6mil-Labs/remake/cad/components/R_0402_1005Metric.step

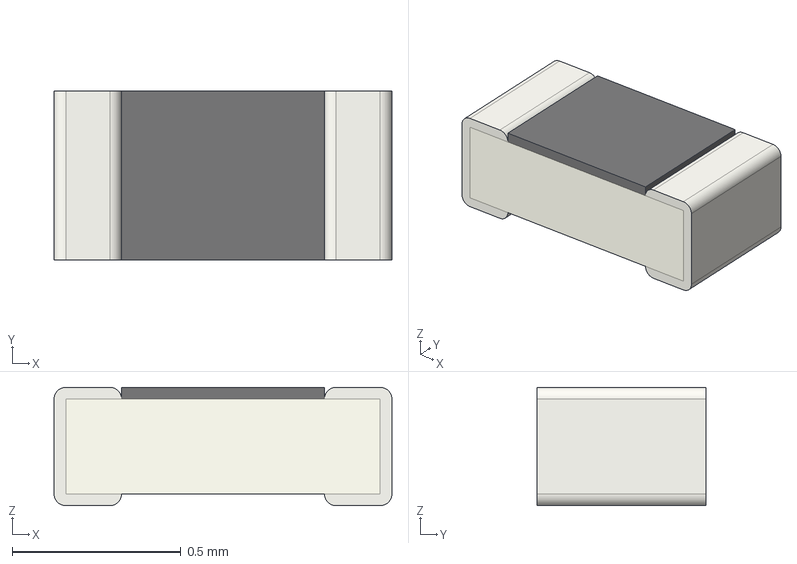
[picture p1: CAD file, 2026-11-06]
cad/components/R_0402_1005Metric.step
1.00 x 0.5 x 0.35 mm
