6mil-Labs/remake/cad/components/SW_Hotswap_Kailh_Choc_V1.step

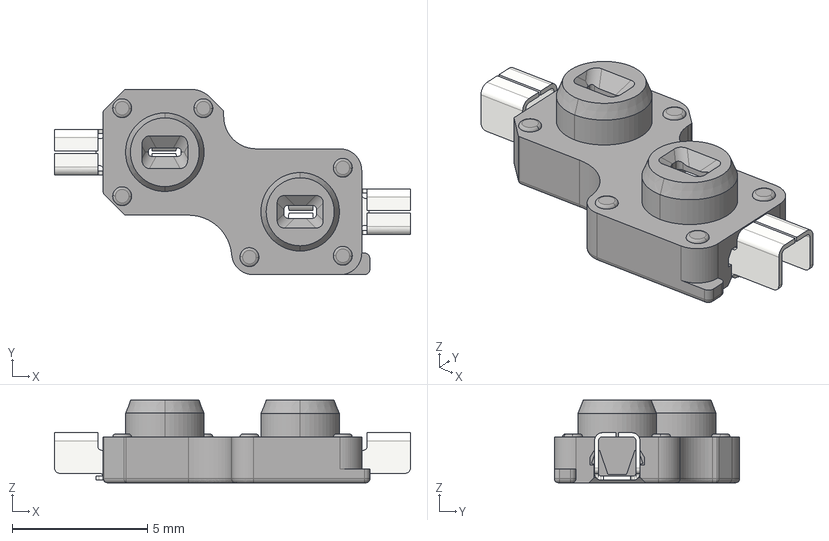
[picture p2: CAD file, 2026-10-26]
cad/components/SW_Hotswap_Kailh_Choc_V1.step
13.2 x 6.85 x 3.05 mm
