6mil-Labs/remake/cad/components/D_SOD123.step

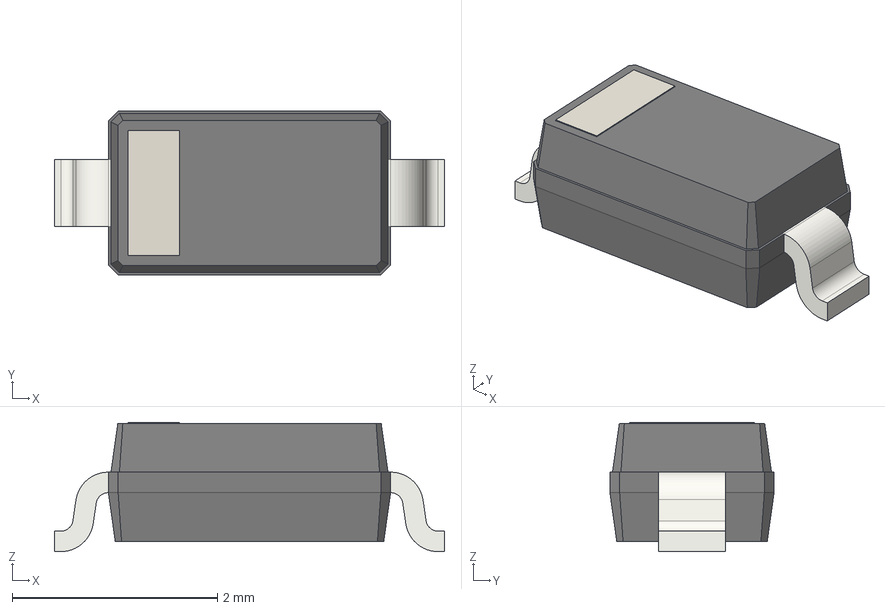
[picture p3: CAD file, 2026-10-26]
cad/components/D_SOD123.step
3.80 x 1.60 x 1.26 mm
