6mil-Labs/remake/cad/components/SW_Kailh_Choc_V1.step

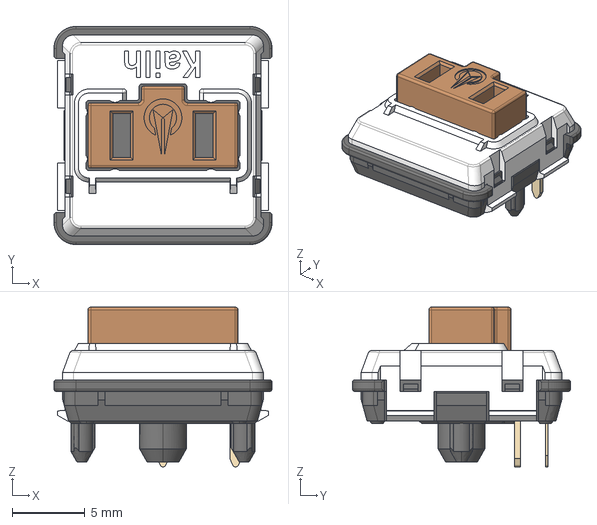
[picture p4: CAD file, 2026-10-26]
cad/components/SW_Kailh_Choc_V1.step
15.0 x 15.0 x 11.0 mm
