6mil-Labs/remake/cad/components/Panasonic_EVQPUJ_EVQPUA.step

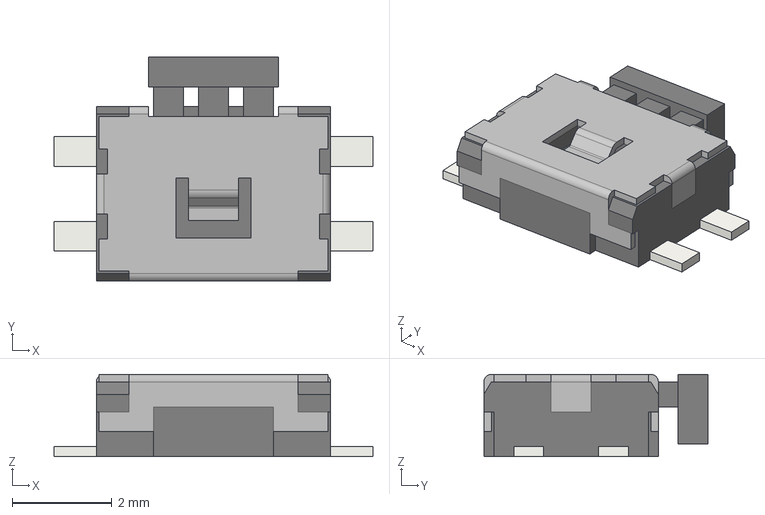
[picture p5: CAD file, 2026-10-26]
cad/components/Panasonic_EVQPUJ_EVQPUA.step
6.40 x 4.50 x 1.65 mm
