6mil-Labs/remake/cad/components/SW_MSK12C02.step

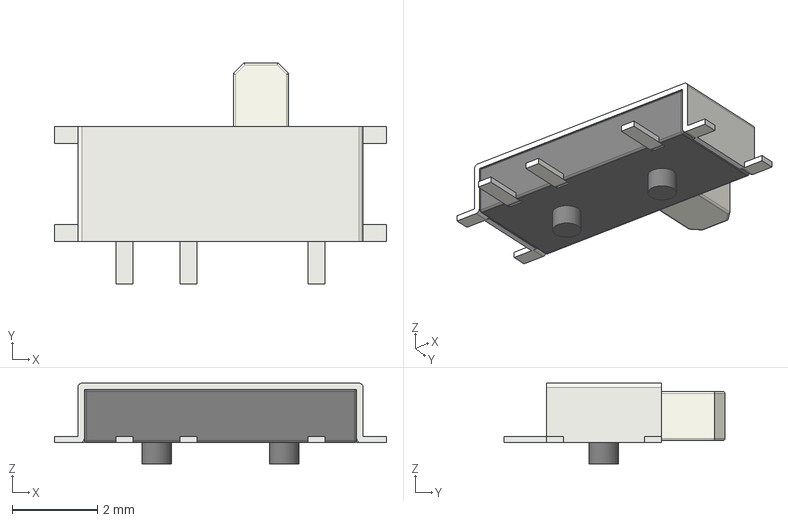
[picture p6: CAD file, 2026-10-26]
cad/components/SW_MSK12C02.step
7.80 x 5.20 x 1.90 mm
