6mil-Labs/remake/hw/remake.kicad_pcb

## KiCad design hw/remake.kicad_pcb (2026-11-13)

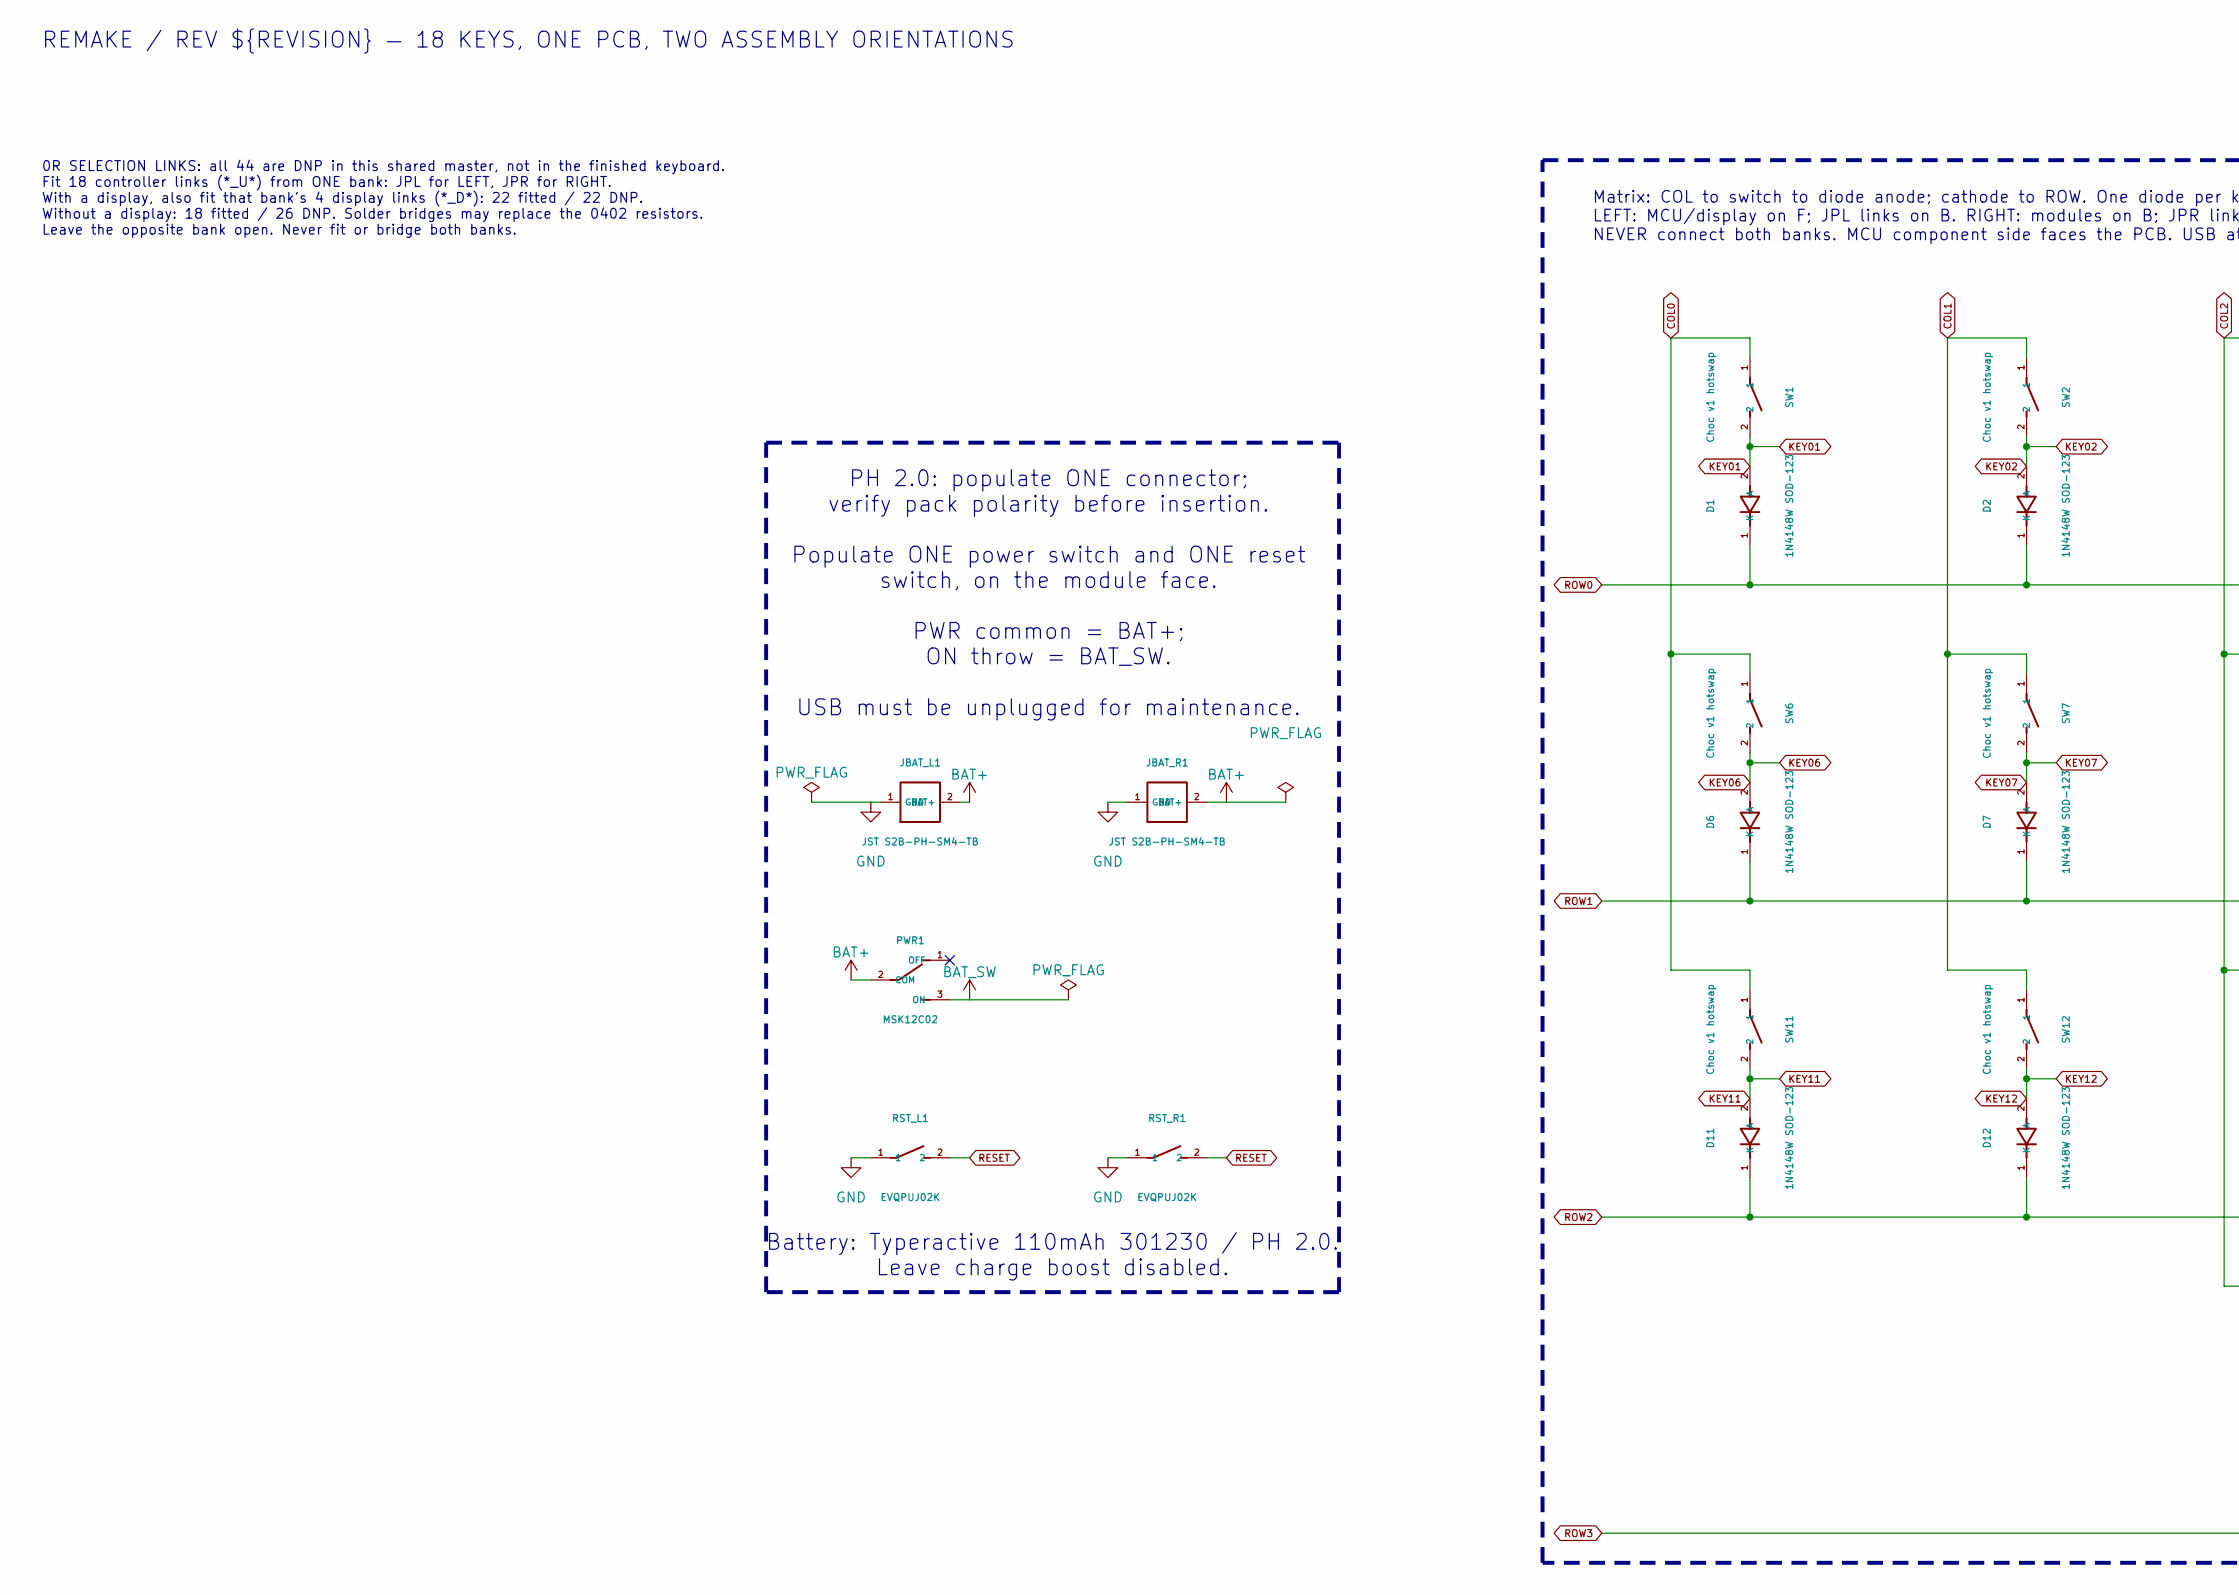
[picture p7: schematic remake.kicad_sch, part in row 1, column 1]

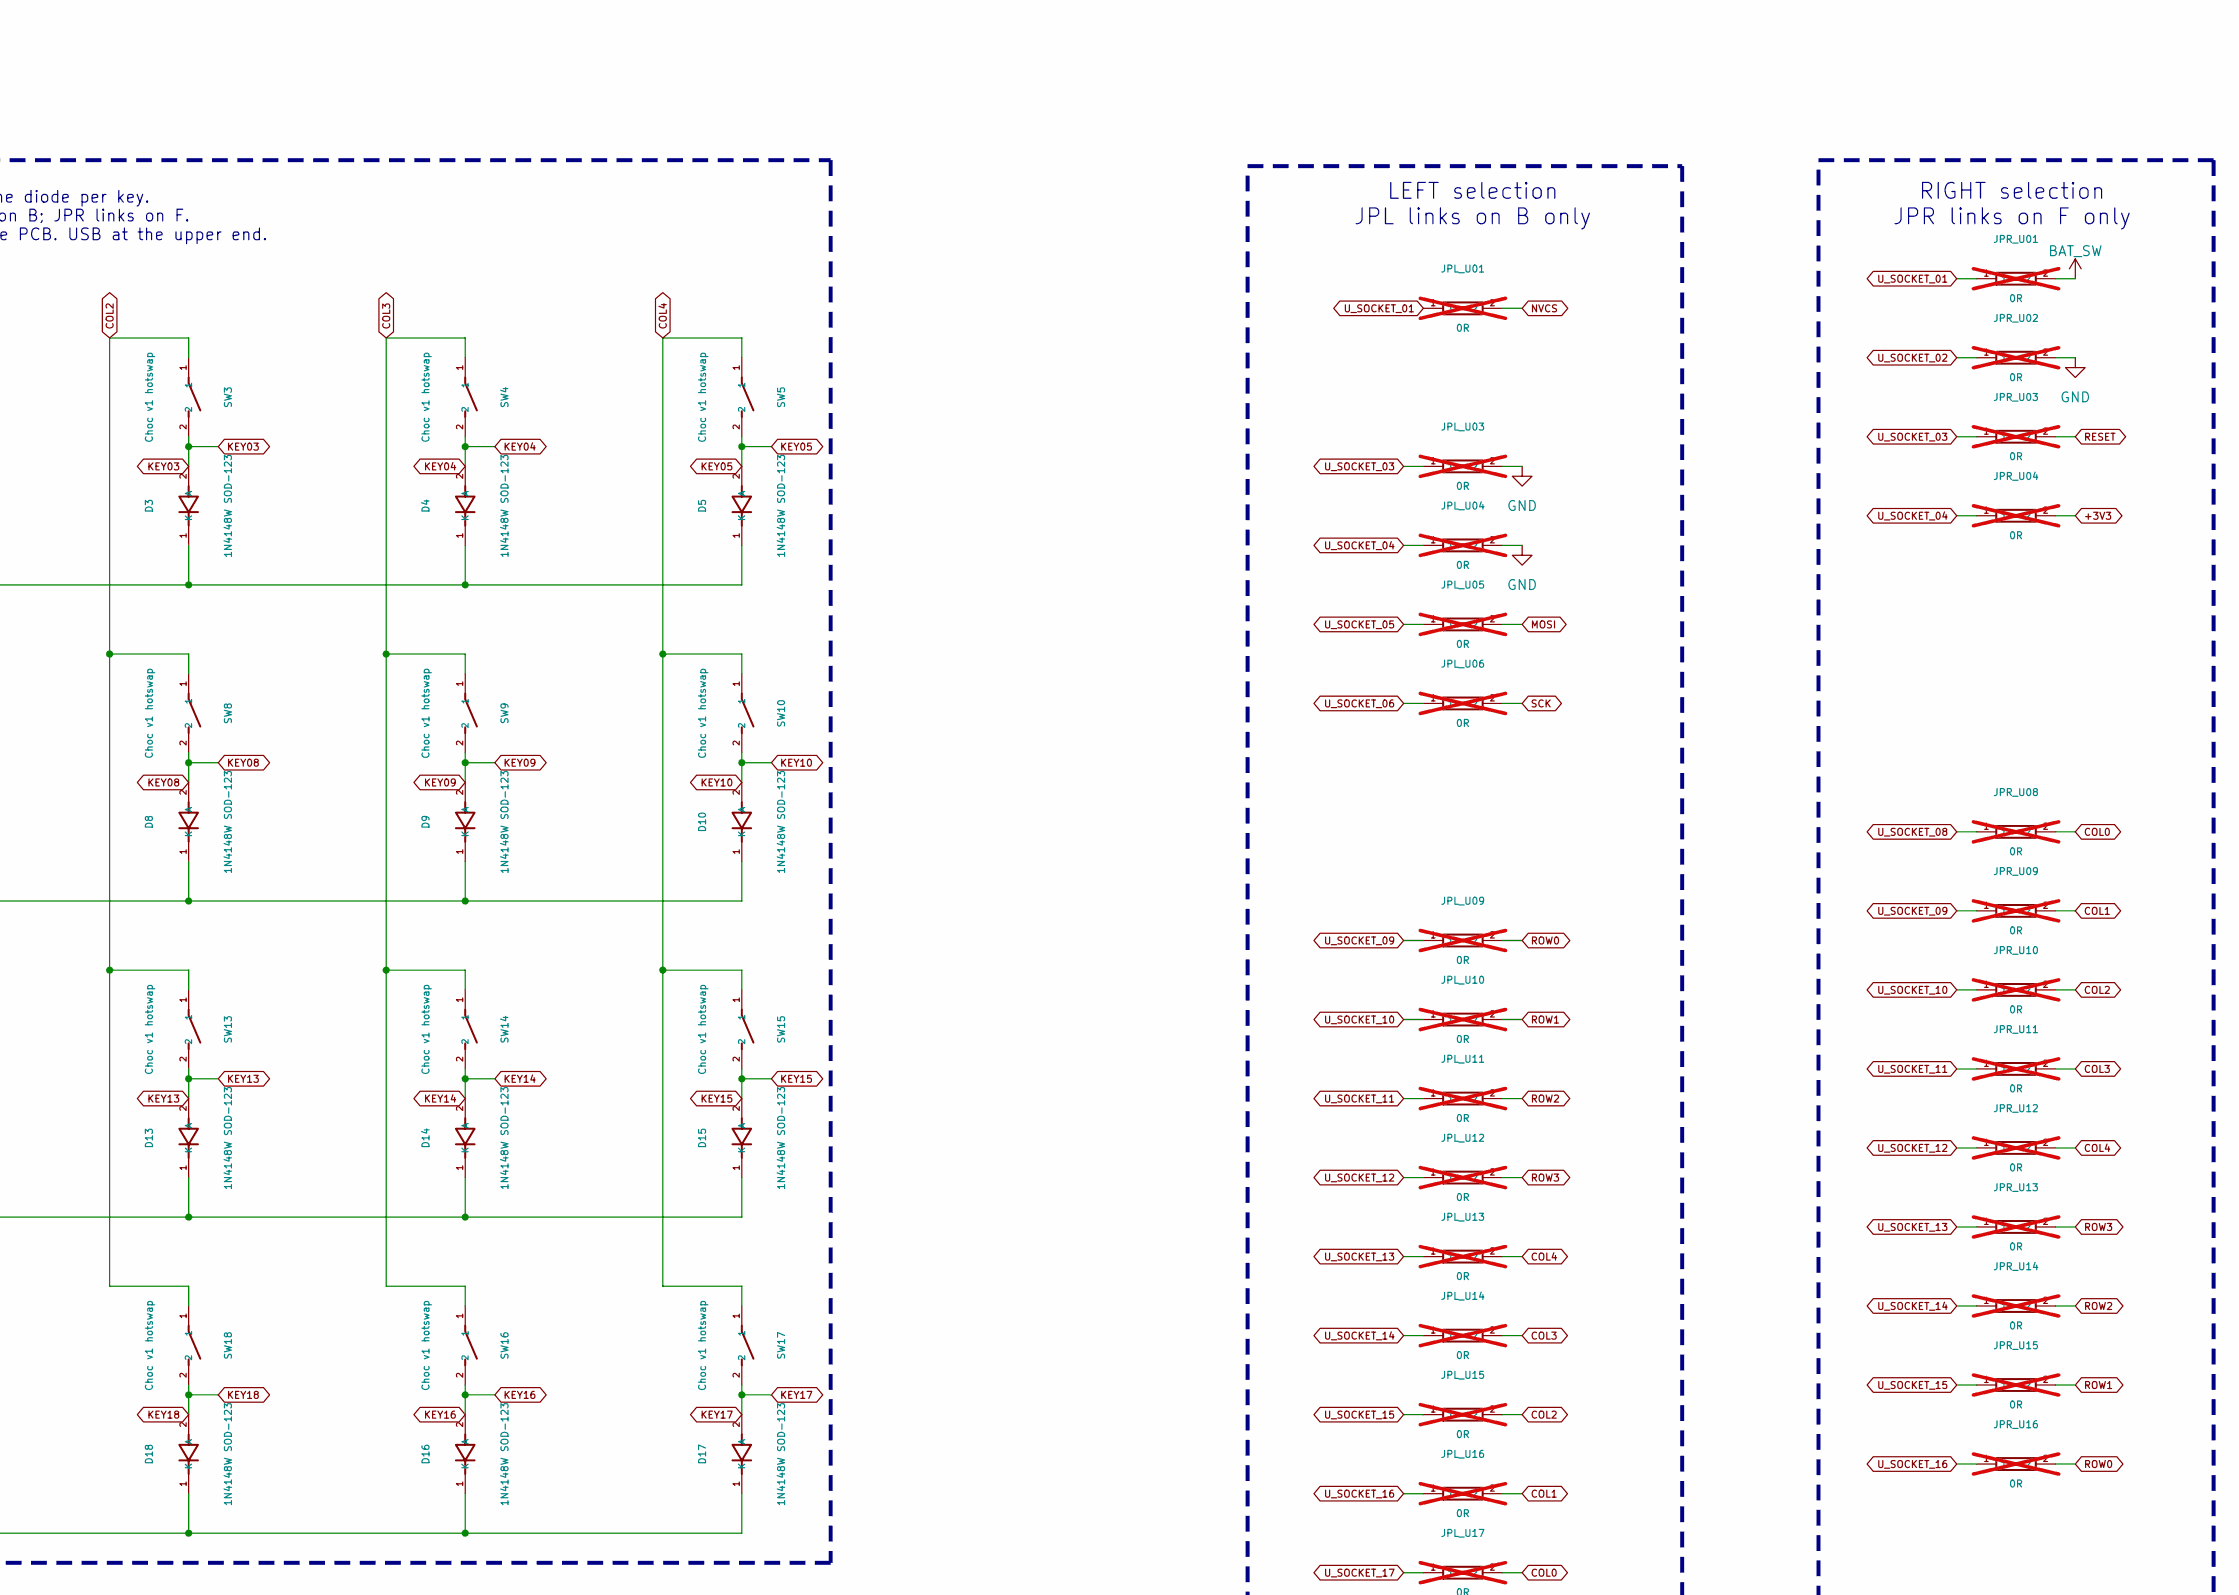
[picture p8: schematic remake.kicad_sch, part in row 1, column 2]

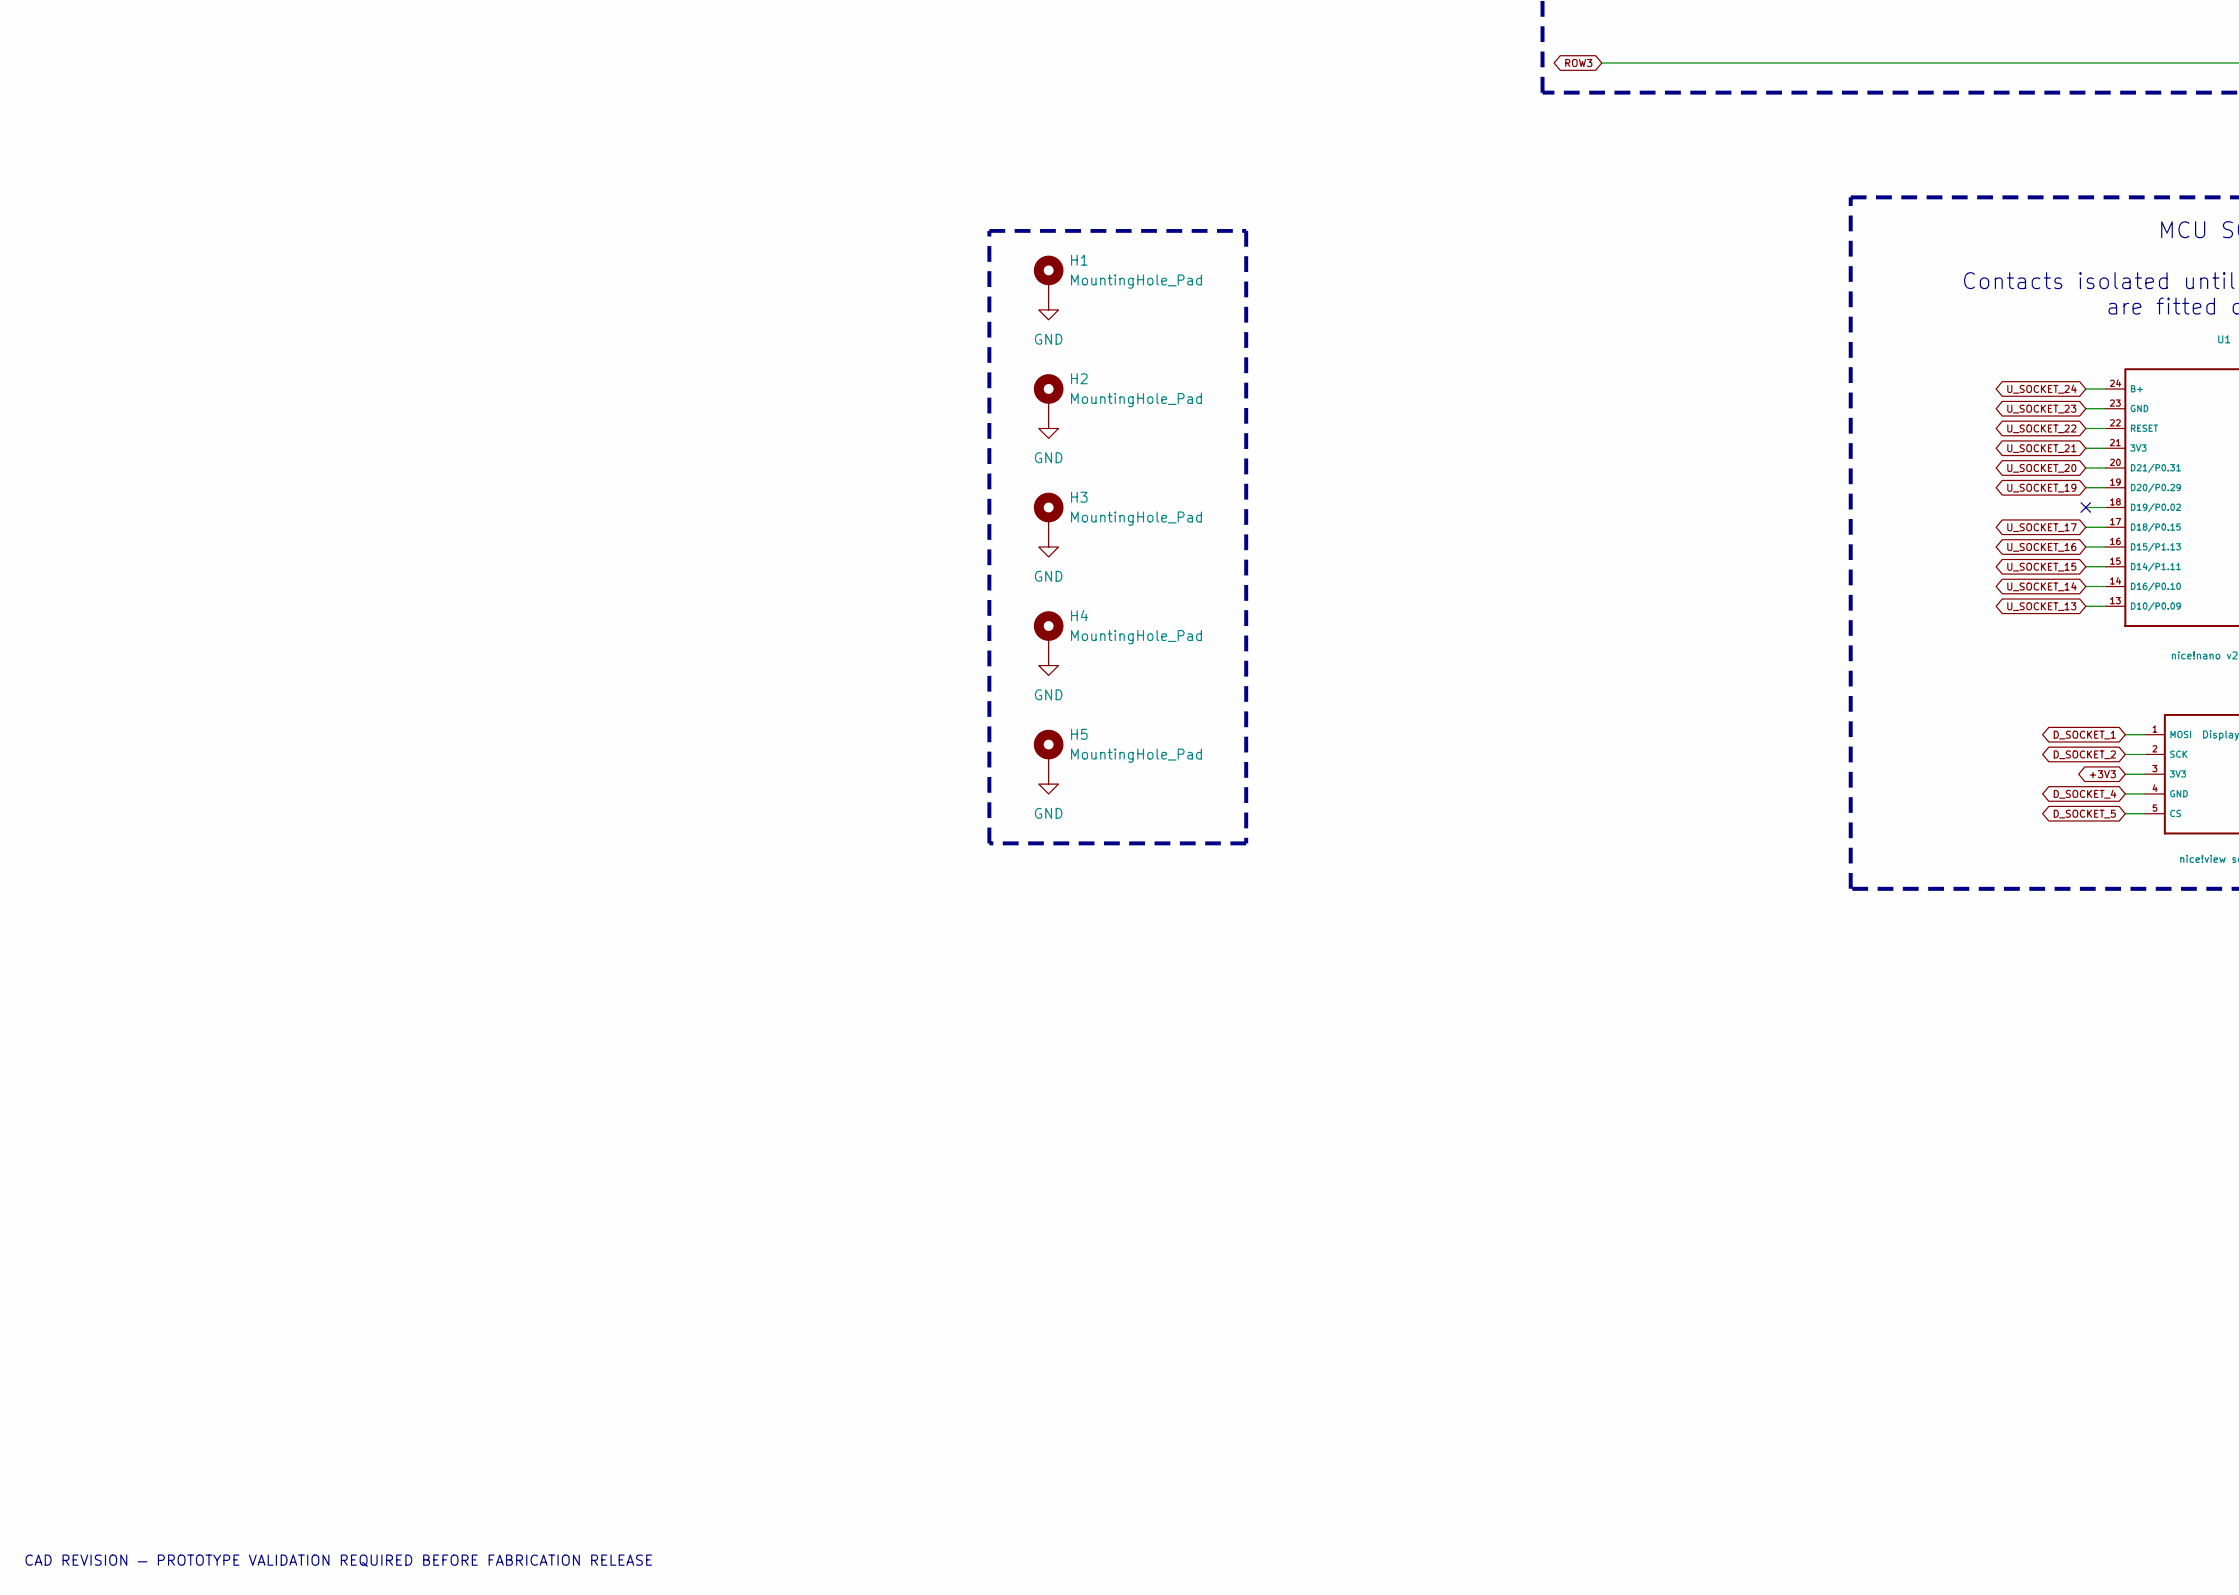
[picture p9: schematic remake.kicad_sch, part in row 2, column 1]

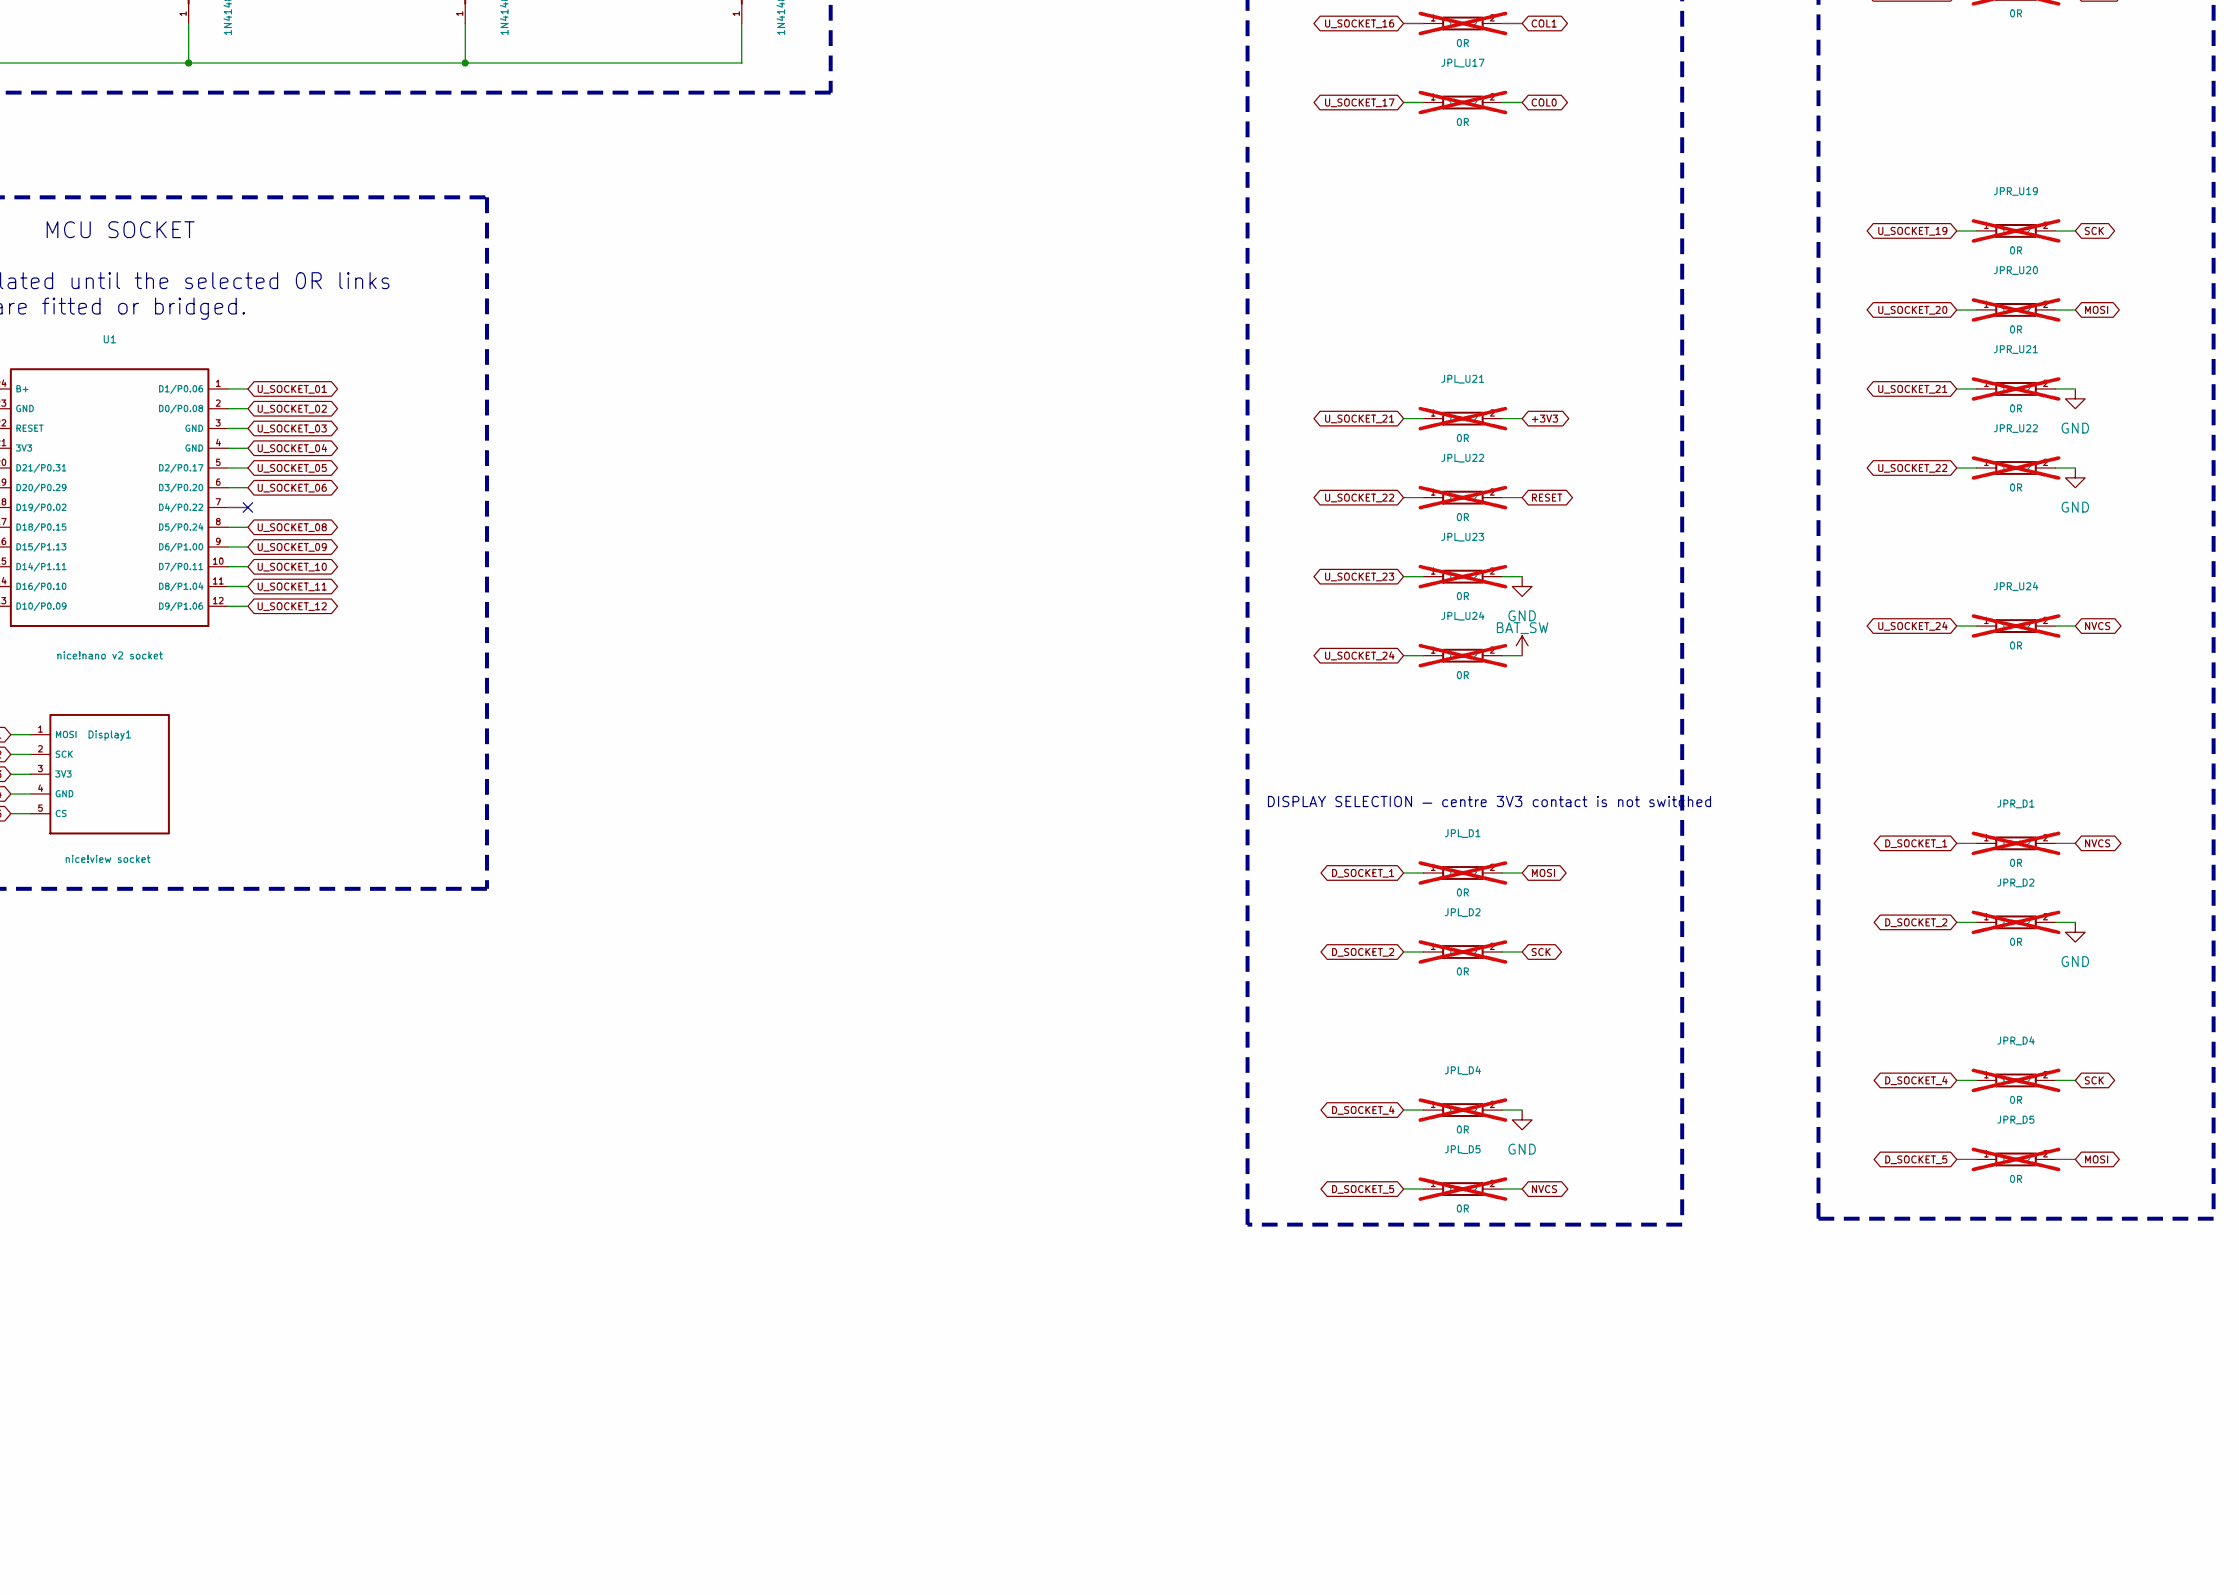
[picture p10: schematic remake.kicad_sch, part in row 2, column 2]

Parts:
D1, D2, D3, D4, D5, D6, D7, D8, D9, D10, D11, D12, D13, D14, D15, D16, D17, D18: 1N4148W SOD-123; Diode_SOD123_reversible
Display1: nice!view socket; nice_view_reversible
H1, H2, H3, H4, H5: MountingHole_Pad; MountingHole_2.2mm_M2_ISO7380_Pad_TopBottom
JBAT_L1: JST S2B-PH-SM4-TB; JST_PH_2mm_side_entry
JBAT_R1: JST S2B-PH-SM4-TB; JST_PH_2mm_side_entry
JPL_D1, JPL_D2, JPL_D4, JPL_D5: 0R; R_0402_1005Metric_SolderJumper; not fitted
JPL_U01, JPL_U03, JPL_U04, JPL_U05, JPL_U06, JPL_U09, JPL_U10, JPL_U11, JPL_U12, JPL_U13, JPL_U14, JPL_U15, JPL_U16, JPL_U17, JPL_U21, JPL_U22, JPL_U23, JPL_U24: 0R; R_0402_1005Metric_SolderJumper; not fitted
JPR_D1, JPR_D2, JPR_D4, JPR_D5: 0R; R_0402_1005Metric_SolderJumper; not fitted
JPR_U01, JPR_U02, JPR_U03, JPR_U04, JPR_U08, JPR_U09, JPR_U10, JPR_U11, JPR_U12, JPR_U13, JPR_U14, JPR_U15, JPR_U16, JPR_U19, JPR_U20, JPR_U21, JPR_U22, JPR_U24: 0R; R_0402_1005Metric_SolderJumper; not fitted
PWR1: MSK12C02; SW_Power_MSK12C02_reversible
RST_L1: EVQPUJ02K; SW_SPST_Panasonic_EVQPUJ02K
RST_R1: EVQPUJ02K; SW_SPST_Panasonic_EVQPUJ02K
SW1, SW2, SW3, SW4, SW5, SW6, SW7, SW8, SW9, SW10, SW11, SW12, SW13, SW14, SW15, SW16, SW17, SW18: Choc v1 hotswap; SW_Hotswap_Kailh_Choc_V1_reversible
U1: nice!nano v2 socket; nice_nano_reversible

Connections:
+3V3: Display1.3 (3V3), JPL_U21.2, JPR_U04.2
BAT+: JBAT_L1.2 (BAT+), JBAT_R1.2 (BAT+), PWR1.2 (COM)
BAT_SW: JPL_U24.2, JPR_U01.2, PWR1.3 (ON)
COL0: JPL_U17.2, JPR_U08.2, SW1.1, SW6.1, SW11.1
COL1: JPL_U16.2, JPR_U09.2, SW2.1, SW7.1, SW12.1
COL2: JPL_U15.2, JPR_U10.2, SW3.1, SW8.1, SW13.1, SW18.1
COL3: JPL_U14.2, JPR_U11.2, SW4.1, SW9.1, SW14.1, SW16.1
COL4: JPL_U13.2, JPR_U12.2, SW5.1, SW10.1, SW15.1, SW17.1
D_SOCKET_1: Display1.1 (MOSI), JPL_D1.1, JPR_D1.1
D_SOCKET_2: Display1.2 (SCK), JPL_D2.1, JPR_D2.1
D_SOCKET_4: Display1.4 (GND), JPL_D4.1, JPR_D4.1
D_SOCKET_5: Display1.5 (CS), JPL_D5.1, JPR_D5.1
GND: H1.1 (1_1), H2.1 (1_1), H3.1 (1_1), H4.1 (1_1), H5.1 (1_1), JBAT_L1.1 (GND), JBAT_R1.1 (GND), JPL_D4.2, JPL_U03.2, JPL_U04.2, JPL_U23.2, JPR_D2.2, JPR_U02.2, JPR_U21.2, JPR_U22.2, RST_L1.1, RST_R1.1
KEY01: D1.2 (A), SW1.2
KEY02: D2.2 (A), SW2.2
KEY03: D3.2 (A), SW3.2
KEY04: D4.2 (A), SW4.2
KEY05: D5.2 (A), SW5.2
KEY06: D6.2 (A), SW6.2
KEY07: D7.2 (A), SW7.2
KEY08: D8.2 (A), SW8.2
KEY09: D9.2 (A), SW9.2
KEY10: D10.2 (A), SW10.2
KEY11: D11.2 (A), SW11.2
KEY12: D12.2 (A), SW12.2
KEY13: D13.2 (A), SW13.2
KEY14: D14.2 (A), SW14.2
KEY15: D15.2 (A), SW15.2
KEY16: D16.2 (A), SW16.2
KEY17: D17.2 (A), SW17.2
KEY18: D18.2 (A), SW18.2
MOSI: JPL_D1.2, JPL_U05.2, JPR_D5.2, JPR_U20.2
NVCS: JPL_D5.2, JPL_U01.2, JPR_D1.2, JPR_U24.2
RESET: JPL_U22.2, JPR_U03.2, RST_L1.2, RST_R1.2
ROW0: D1.1 (K), D2.1 (K), D3.1 (K), D4.1 (K), D5.1 (K), JPL_U09.2, JPR_U16.2
ROW1: D6.1 (K), D7.1 (K), D8.1 (K), D9.1 (K), D10.1 (K), JPL_U10.2, JPR_U15.2
ROW2: D11.1 (K), D12.1 (K), D13.1 (K), D14.1 (K), D15.1 (K), JPL_U11.2, JPR_U14.2
ROW3: D16.1 (K), D17.1 (K), D18.1 (K), JPL_U12.2, JPR_U13.2
SCK: JPL_D2.2, JPL_U06.2, JPR_D4.2, JPR_U19.2
U_SOCKET_01: JPL_U01.1, JPR_U01.1, U1.1 (D1/P0.06)
U_SOCKET_02: JPR_U02.1, U1.2 (D0/P0.08)
U_SOCKET_03: JPL_U03.1, JPR_U03.1, U1.3 (GND)
U_SOCKET_04: JPL_U04.1, JPR_U04.1, U1.4 (GND)
U_SOCKET_05: JPL_U05.1, U1.5 (D2/P0.17)
U_SOCKET_06: JPL_U06.1, U1.6 (D3/P0.20)
U_SOCKET_08: JPR_U08.1, U1.8 (D5/P0.24)
U_SOCKET_09: JPL_U09.1, JPR_U09.1, U1.9 (D6/P1.00)
U_SOCKET_10: JPL_U10.1, JPR_U10.1, U1.10 (D7/P0.11)
U_SOCKET_11: JPL_U11.1, JPR_U11.1, U1.11 (D8/P1.04)
U_SOCKET_12: JPL_U12.1, JPR_U12.1, U1.12 (D9/P1.06)
U_SOCKET_13: JPL_U13.1, JPR_U13.1, U1.13 (D10/P0.09)
U_SOCKET_14: JPL_U14.1, JPR_U14.1, U1.14 (D16/P0.10)
U_SOCKET_15: JPL_U15.1, JPR_U15.1, U1.15 (D14/P1.11)
U_SOCKET_16: JPL_U16.1, JPR_U16.1, U1.16 (D15/P1.13)
U_SOCKET_17: JPL_U17.1, U1.17 (D18/P0.15)
U_SOCKET_19: JPR_U19.1, U1.19 (D20/P0.29)
U_SOCKET_20: JPR_U20.1, U1.20 (D21/P0.31)
U_SOCKET_21: JPL_U21.1, JPR_U21.1, U1.21 (3V3)
U_SOCKET_22: JPL_U22.1, JPR_U22.1, U1.22 (RESET)
U_SOCKET_23: JPL_U23.1, U1.23 (GND)
U_SOCKET_24: JPL_U24.1, JPR_U24.1, U1.24 (B+)

Notes on the sheet:
DISPLAY SELECTION — centre 3V3 contact is not switched
CAD REVISION — PROTOTYPE VALIDATION REQUIRED BEFORE FABRICATION RELEASE
REMAKE / REV ${REVISION} — 18 KEYS, ONE PCB, TWO ASSEMBLY ORIENTATIONS
LEFT selection JPL links on B only
PH 2.0: populate ONE connector; verify pack polarity before insertion. Populate ONE power switch and ONE reset switch, on the module face. PWR common = BAT+; ON throw = BAT_SW. USB must be unplugged for maintenance.
MCU SOCKET Contacts isolated until the selected 0R links are fitted or bridged.
Matrix: COL to switch to diode anode; cathode to ROW. One diode per key. LEFT: MCU/display on F; JPL links on B. RIGHT: modules on B; JPR links on F. NEVER connect both banks. MCU component side faces the PCB. USB at the upper end.
Battery: Typeractive 110mAh 301230 / PH 2.0. Leave charge boost disabled.
RIGHT selection JPR links on F only
0R SELECTION LINKS: all 44 are DNP in this shared master, not in the finished keyboard. Fit 18 controller links (*_U*) from ONE bank: JPL for LEFT, JPR for RIGHT. With a display, also fit that bank's 4 display links (*_D*): 22 fitted / 22 DNP. Without a display: 18 fitted / 26 DNP. Solder bridges m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

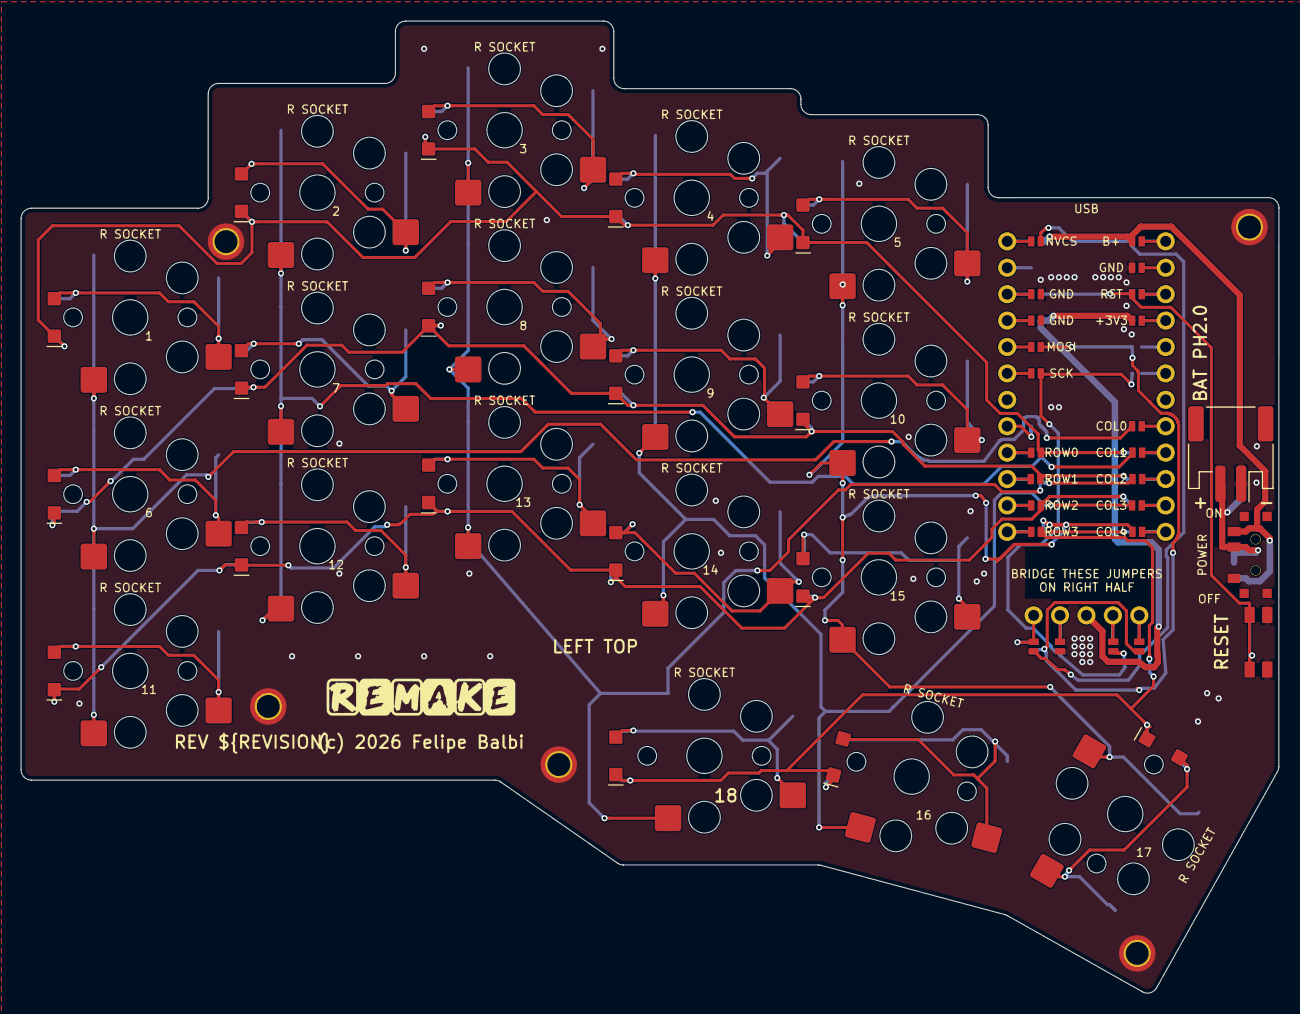
[picture p11: board remake.kicad_pcb from above]

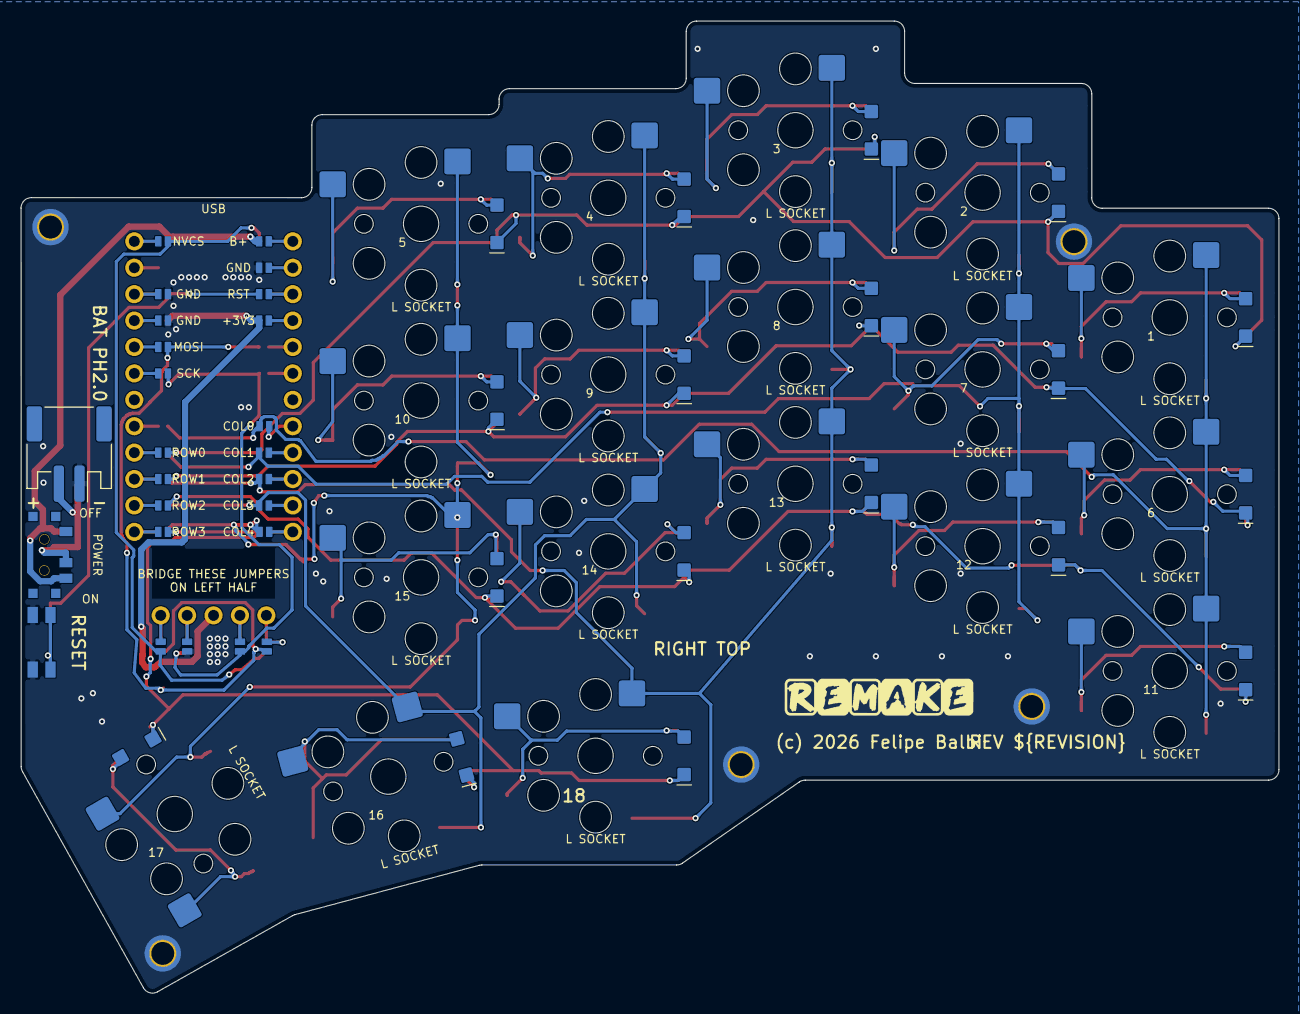
[picture p12: board remake.kicad_pcb from below]

Board: 2 copper layers, 121.0 x 93.5 mm, 93 parts (24 on the bottom side), 61 nets.

Other parts of the board:
LOGO1: REMAKE; Logo_REMAKE
