6mil-Labs/remake/(commit log)

2026-10-26 REMAKE: Initial commit
    [D_SOD123.step, Panasonic_EVQPUJ_EVQPUA.step, SW_Hotswap_Kailh_Choc_V1.step, SW_Kailh_Choc_V1.step, SW_MSK12C02.step, remake.kicad_pcb, remake.kicad_sch]
2026-10-26 REMAKE: fix ERC warning
    [remake.kicad_pcb, remake.kicad_sch]
2026-10-26 REMAKE: fix DRC warnings/errors
    [remake.kicad_pcb]
2026-10-31 REMAKE: update tracks and via locations
    [remake.kicad_pcb]
2026-11-06 REMAKE: REV 0.2-RC2
    [remake.kicad_pcb, remake.kicad_sch]
2026-11-06 REMAKE: remove solder mask between solder jumper pads
    [remake.kicad_pcb]
2026-11-06 REMAKE: even the gap between thumb cluster keys
    [remake.kicad_pcb]
2026-11-06 REMAKE: support 0402 zero-ohm selection links
    Keep manual solder-bridge support with a connected mask opening and
    separate 0402 paste apertures. Mark all selection links DNP in the
    shared master and document left/right population.
    Move two vias out of paste apertures, separate schematic value fields,
    and extend native export regression coverage.
    [remake.kicad_pcb, remake.kicad_sch]
2026-11-06 REMAKE: add R_0402 step file
    [R_0402_1005Metric.step, remake.kicad_pcb]
2026-11-06 REMAKE: REV 0.2-RC3
    [remake.kicad_pcb]
2026-11-07 REMAKE: rotate thumb key for 1.25U keycap
    While at that, also improve the location for battery jack, reset switch,
    and power switch
    [remake.kicad_pcb]
2026-11-08 docs: track revision validation status
2026-11-08 REMAKE: 0.2
    [remake.kicad_pcb]
2026-11-13 REMAKE: update PCB outline
    [remake.kicad_pcb]
